UVA-DSI/sensenet/(notices)

Notices in the files:
projects/NPS/board/board.sch:
License: CERN OHL-S v2, see AUTHORS and LICENSE files for details
